JakubKostecki/Arduino-plant-watering-system/README.md

# Arduino-plant-watering-system

System made with collaboration with my Friend
