JakubKostecki/Arduino-plant-watering-system/Raport_Koncowy_JK_SK (1).pdf

# Raport końcowy

# Automatyczny System Podlewania Roślin

Wykonali:

Jakub Kostecki

Szymon Krzyworzeka

Prowadzący:

Dr. hab. inż. Barbara Swatowska

Dr. hab. inż. Andrzej Brudnik

## Spis treści:

## 1. Rozpoznanie rozwiązań w literaturze

## 2. Propozycje realizacji projektu brane pod uwagę

## 3. Realizacja Projektu

## 4. Testy/Uwagi

## 1. Rozpoznanie rozwiązań w literaturze

Cel projektu:

Celem projektu było zaprojektowanie i zbudowanie automatycznego systemu podlewającego rośliny doniczkowe na podstawie pomiaru wilgotności gleby. Urządzenie ma być małych rozmiarów, przenośne i nie wymagać podłączenia do sieci elektrycznej ani wodociągowej. W przypadku braku wody w zbiorniku do podlewania, system informuje o tym użytkownika.

Informowanie o konieczności podlania (2) (https://budmech.pl/czujniki-wilgotnosci-gleby-rozwiazanie-prawie-idealne/)

Pomiar wilgotności gleby.
Zastosowanie czujnika wilgotności gleby umożliwia stałą kontrolę nad poziomem nawodnienia gleby. Pozwala to uniknąć sytuacji gdzie częstotliwość nawadniania nie jest wystarczająca w zaistniałych warunkach zewnętrznych. Minusem takiego rozwiązania jest konieczność założenia, że gleba powinna być stale wilgotna.

Sposób nawadniania rośliny (3) (https://www.nawodnienia.eu/aktualnosci/system-nawadniania-zrob-to-sam-01-jak-zmierzyc-zrodlo-wody,p244767956)

Pobieranie wody ze zbiornika.
Główna zaletą takiego rozwiązania jest możliwość instalacji urządzenia bez konieczności podłączania się do systemu wodnego, dzięki czemu urządzenie nabiera charakteru przenośnego. Powstaje natomiast problem wyczerpywania się wody w zbiorniku. Implementacja systemu powiadamiającego o niskim poziomie wody zapobiega sytuacji w której roślina nie może zostać podlana. Woda ze zbiornika jest pobierana z niego za pomocą pompy zanurzeniowej, bądź pompy wodnej.

Obsługa systemu

Najprostszym rozwiązaniem jest zastosowanie mikrokontrolera, który kontroluje pracę systemu nawadniającego.

Kontrola Poziomu wody w zbiorniku (4)( (https://holmes.iigw.pl/~wbanach/dydaktyka/hydrologia_inf/pliki/laboratorium/pomiar_stanu_wody.pdf)5)( (https://automatykab2b.pl/technika/38496-pomiary-poziomu-cieczy-i-materialow-sypkich)6) (https://www.youtube.com/watch?v=RoqwsGKcHNU&ab_channel=MuzeumElektroniki-%C5%81ukaszBazarnik)

Zastosowanie rezystancyjnego czujnika poziomu wody.
Zaletą takiego rozwiązania jest możliwość bezpośredniej kontroli wody w zbiorniku (pomiar jest pobierany bezpośrednio ze zbiornika a nie wyliczany na podstawie przewidywanego stanu układu po danym czasie pracy). Nie jest jednak idealne, gdyż czujnik wilgotności może być podatny na parowanie wody, która osadzając się na czujniku może przekłamywać pomiar

Zasilanie układu (7) (https://intertechacademy.pl/2021/01/zasilanie-elektroniki-z-baterii-i-akumulatorow/)

Baterie
Zaletą takiego rozwiązania jest brak konieczności dostępu do sieci elektrycznej. Jednak baterie alkaliczne są trudne w utylizacji i należy je stale wymieniać.

Sposoby powiadamiania o niskim poziomie wody w zbiorniku

Za pomocą dźwięku
Zainstalowanie małego głośnika w systemie pozwala na odtwarzanie dźwięku. Takie rozwiązanie pozwala skutecznie powiadomić użytkownika o konieczności uzupełnienia zbiornika z wodą.

Zdalne monitorowanie pojemności zbiornika wody
Za pomocą mikrokontrolera oraz modułu WI-FI wykonano stronę internetową, która w czasie rzeczywistym informuje użytkownika o stanie wody w zbiorniku

## 2. Propozycje realizacji projektu brane pod uwagę

Elementy potrzebne do realizacji projektu

- Mikrokontroler (obsługa sensorów)
- Czujnik wilgotności gleby
- Czujnik poziomu wody w zbiorniku
- Zasilanie (bateria)
- Przekaźnik
- Pompa do cieczy
- Urządzenie powiadamiające o niskim poziomie wody za pomocą dźwięku

### 1. Moduł z mikrokontrolerem

- Moduł WiFi ESP8266 + NodeMCU v3

To urządzenie sprosta naszym wymaganiom, może być programowanie z użyciem języka Arduino i jest w dobrej cenie. Dodatkowo ma wbudowany moduł Wi-Fi który jest konieczny do stworzenia strony internetowej wyświetlającej stan wody w zbiorniku.

### 2. Czujnik wilgotności gleby

- MOD-01588

To urządzenie jest w przystępnej cenie i posiada wyjście cyfrowe. Jest kompatybilne z Arduino.

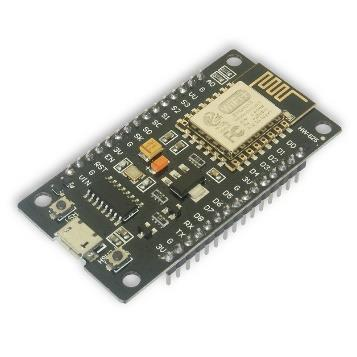
[picture p1: figure]

Zdjęcie 1 - Moduł ESP8266
Źródło : botland (https://botland.com.pl/moduly-wifi-esp8266/8241-modul-wifi-esp8266-nodemcu-v3-5904422300630.html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)

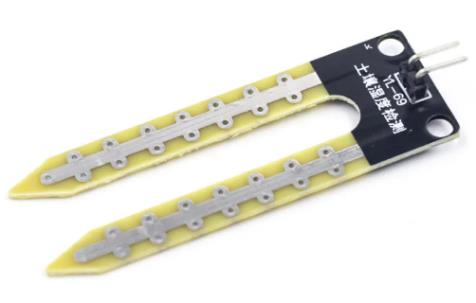
[picture p2: figure]

Zdjęcie 2 - Czujnik wilgotności gleby Źródło : modulosy (https://modulosy.pl/czujniki-wilgotnosci/282-czujnik-sensor-wilgotnosci-gleby-sensor-hygrometr-do-arduino-5903689131353.html)

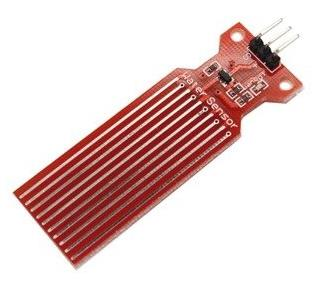
[picture p3: figure]

### 3. Czujnik poziomu wody

- Iduino SE045

Czujnik służący do wyznaczania poziomu cieczy w naczyniu. Zasilany jest napięciem 5,0 V. Wyjściem jest napięcie analogowe, które zwiększa swoją wartość wraz głębokością zanurzenia sondy.

### 4. Zasilanie

- Baterie alkaliczne

Baterie alkaliczne pozwalają na zminimalizowanie wymiarów urządzenia, ponadto są stosunkowo tanie.

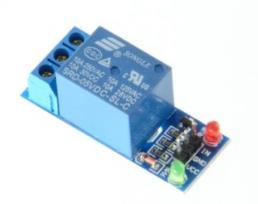
[picture p4: figure]

### 5. Przekaźnik do sterowania pompą wodną

- Przekaźnik

Moduł wyposażony w przekaźnik JQC-3FF-S-Z z cewką zasilaną napięciem 5 V bez optycznej izolacji wejścia. Układ pozwala na sterowanie elementami wykonawczymi przy pomocy portów mikrokontrolera lub dowolnego zestawu uruchomieniowego. Pracuje z napięciem do 250 V. Jest to element umożliwiający galwaniczne odseparowanie modułu pompy od reszty układu

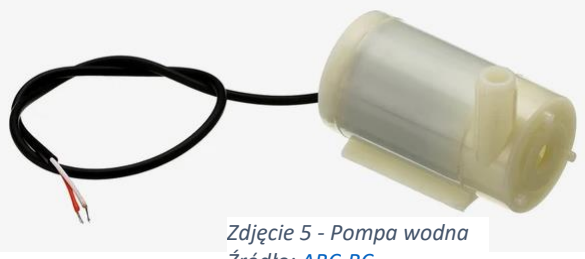
[picture p5: figure]
Zdjęcie 5 - Pompa wodna

### 6. Pompa do cieczy

- Pompa wodna 6V GRL-14164

Ta pompa jest zasilana niskim napięciem i nie ma dużego przepływu wody co pomoże uniknąć problemów związanych z ewentualnym rozlaniem

### 7. Urządzenie powiadamiające o niskim poziomie wody

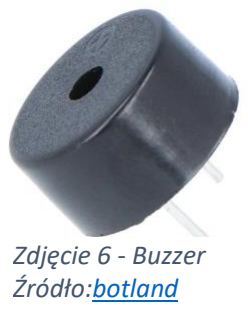
[picture p6: figure]
Zdjęcie 6 - Buzzer Źródło:botland

- Buzzer

Buzzer bez generatora o średnicy 14 mm. Zasilany napięciem z zakresu od 3 V do 16 V zdolny do wytwarzania dźwięku do 80 dB

Zdjęcie 3 - Czujnik poziomu wody Źródło : ABC-RC (https://abc-rc.pl/product-pol-6320-Czujnik-poziomu-wody-Water-Sensor-do-Arduino.html)

Zdjęcie 4 - Przekaźnik
Źródło: kostrzewniki (https://kostrzewinki.pl/modul-przekaznika-systemie-domoticz/)

Źródło: ABC-RC (https://abc-rc.pl/product-pol-9181-Mini-Pompa-do-wody-DC-3V-6V-1W-100l-h-pompka-cieczy.html)

Potencjalne problemy przy realizacji projektu na które trzeba zwrócić uwagę

1. Mały rozmiar układu i jego podręczność
2. Szczelność uszczelek przy pompie wodnej
3. Rozsądny i świadomy wybór komponentów pozwalający na zminimalizowanie rozmiaru oraz wagi układu.
4. Dodatkowe zabezpieczenie połączeń węży hydraulicznych

Pozostałe elementy niezbędne do wykonania projektu

- Przekaźnik
- Buzzer
- Przewody
- Rurki PCV
- Naczynie na wodę
- Doniczka z rośliną

Wycena komponentów na dzień 15.10.2022

Komponent | Cena zł
Mikrokontroler (obsługa sensorów) | 26,10
Czujnik wilgotności gleby | 5,50
Czujnik poziomu wody w zbiorniku | 3,90
Zasilanie (bateria) | 11,20
Przekaźnik | 7,90
Pompa do cieczy | 24.90
Buzzer | 2,20
Diody LED | 4,90
Przewody | 5,10
Rurki PCV | 9,00
Roślina doniczkowa | 15,00
Naczynie na wodę | 10,00
Dostawa | 9,90
SUMA | 135,60

## 3. Realizacja projektu

Część sprzętowa

Prototyp układu został zmontowany przy użyciu przewodów połączeniowych według schematu na rysunku X Układ jest zasilany za pomocą przenośnej ładowarki oraz baterii 9V przy czym bateria jest odpowiedzialna wyłącznie za zasilanie pompy. Zastosowany w prototypie czujnik wilgotności gleby daje na wyjściu sygnał cyfrowy gdzie stan wysoki wyjścia czujnika odpowiada niskiej wilgotności gleby. Do sygnalizacji konieczności uzupełnienia wody w zbiorniku wykorzystano buzzer aktywowany stanem wysokim w momencie, gdy odczyt czujnika wilgotności wskaże, że w zbiorniku jest pusto.

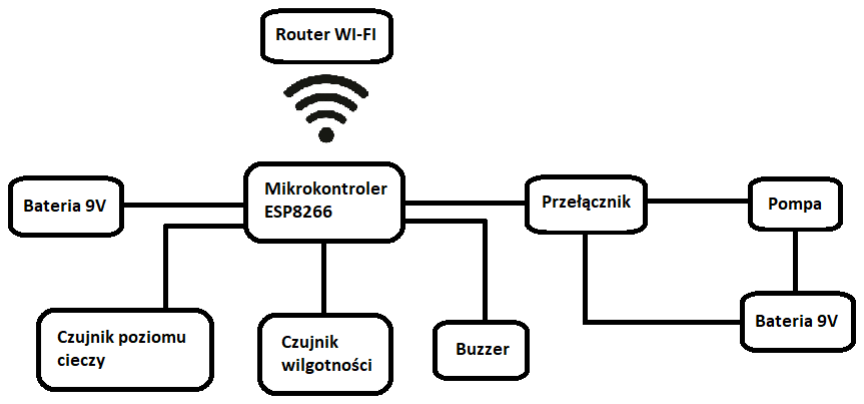
[picture p7: figure]

Rysunek 1- Schemat montażowy prototypu układu

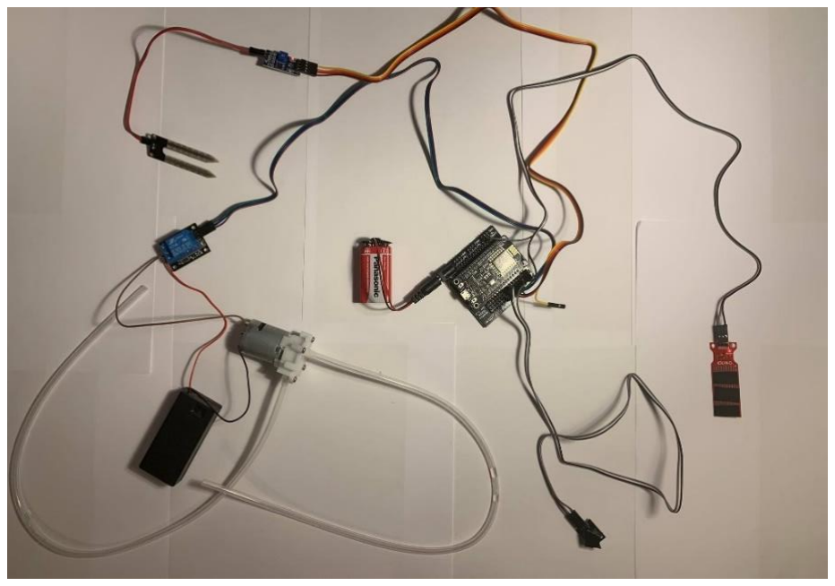
[picture p8: figure]

Zdjęcie 7 - Prototyp układu

Część programowa

Czujnik poziomu cieczy daje na wyjściu sygnał analogowy o natężeniu proporcjonalnym do zanurzenia sensora w wodzie. Na podstawie jego wskazania można ustalić 4 poziomy wody przyjazne do odczytu dające ogólne pojęcie o stanie zbiornika.

a. Odczyt czujnika < 200 – pusto
b. 200 < Odczyt czujnika < 400 – stan niski
c. 400 < Odczyt czujnika < 450 – stan średni
d. 450 < Odczyt czujnika – stan wysoki

Takie informacje są możliwe do odczytania korzystając z urządzeń połączonych do sieci WI-FI jeśli układ jest z nią powiązany.

Aby uniknąć aktywacji pompy w momencie, gdy w zbiorniku nie ma wody zaprogramowano kontroler w taki sposób, aby umożliwiał aktywację pompy wyłącznie, gdy wskazanie czujnika poziomu cieczy jest wyższe niż 200. Zatem pompa jest uruchamiana za pomocą przełącznika gdy dwa warunki zostaną spełnione:

a. W zbiorniku znajduje się wystarczająco wody aby zapewnić bezpieczną i wydajną pracę pompy
b. Pojawienie się stanu niskiego na wyjściu czujnika wilgotności gleby

Aby korzystać z modułu WI-FI konieczne było skorzystanie z biblioteki ESP8266WiFi

Aby utworzyć serwer asynchroniczny i za jego pośrednictwem wyświetlać informacje o stanie wody w zbiorniku skorzystano z biblioteki ESPAsyncWebServer powstałej w oparciu o bibliotekę ESPAsyncTCP.

Strona internetowa została stworzona w HTML i dane z czujnika poziomu cieczy są do niej przesyłane w funkcji

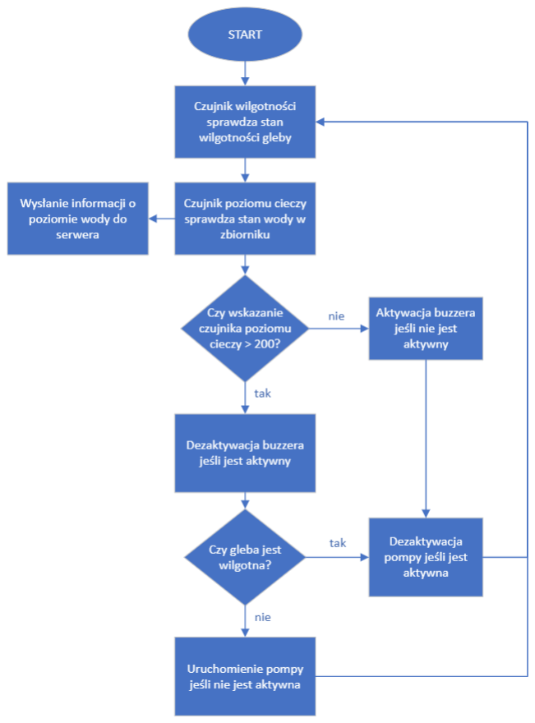
[picture p9: figure]

Rysunek 2- schemat blokowy kodu obsługującego system nawadniania

## 4. Testy i uwagi

Po zmontowaniu układu na płytce drukowanej (zdjęcie nr. 10), układ przeszedł do fazy testowania.

Wykonano testy działania systemu aby sprawdzić poprawność działania w następujących przypadkach:
a) W zbiorniku znajduje się woda i gleba jest wilgotna - urządzenie zgodnie z założeniami nie
uruchamia | | | | | | | pompy
b) W zbiorniku znajduje się woda i gleba jest sucha - urządzenie zgodnie z założeniami
uruchamia | | | | | | | pompę
c) Zbiornik na wodę jest pusty i gleba jest wilgotna - urządzenie uruchamia buzzer i sygnalizuje
konieczność | uzupełnienia | wody | w | zbiorniku, | pompa | pozostaje | nieaktywna
d) Zbiornik na wodę jest pusty i gleba jest sucha - urządzenie uruchamia buzzer i sygnalizuje konieczność uzupełnienia wody w zbiorniku, pompa pozostaje nieaktywna

Wykonano także testy informowania o poziomie wody w zbiorniku, zauważono iż czasami wskazanie czujnika poziomu może być przekłamane w sytuacji, gdy w krótkim czasie urządzenie wykorzystało znaczną część wody ze zbiornika. Powodem takiego zachowania układu jest fakt, że woda na czujniku poziomu osadza się i musi upłynąć trochę czasu aby niezanurzona część czujnika wyschła. Po upływie paru minut odczyt się stabilizuje i pozostaje zgodny ze stanem rzeczywistym.

Uruchomiono układ na okres 5 dni i aby sprawdzić wytrzymałość komponentów. Podczas okresu testowego przełącznik uruchamiający pompę przestał działać, konieczna była wymiana na nowy model, ponieważ poprzedni był wadliwy.

Dodatkowo zauważono, że czujniki wilgotności gleby i poziomu wody w zbiorniku szybko się zużywają i muszą być wymieniane. Ze względu na konieczność wymiany komponentów zdecydowano się na zastosowanie płytki drukowanej, co ułatwia proces wymiany, ponieważ użytkownik nie musi się martwić o odpowiednie podłączenie okablowania do mikrokontrolera.

Konieczność wymiany rurek odprowadzających ciecz z pompy wodnej. Początkowo użyto rurek z poliuretanu, takowy materiał nie nadaje się do zastosowania przy pompie o mocy 5V. Przy wymianie materiału z którego są wykonane rurki na silikon, woda przepływała przez pompę bez zarzutów.

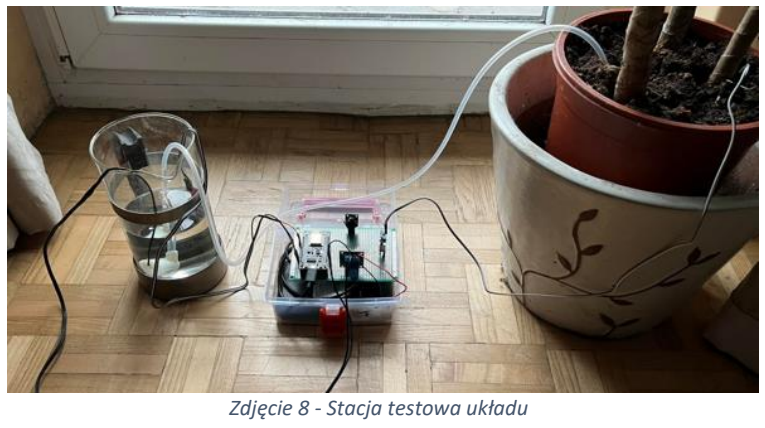
[picture p10: figure]
Zdjęcie 8 - Stacja testowa układu
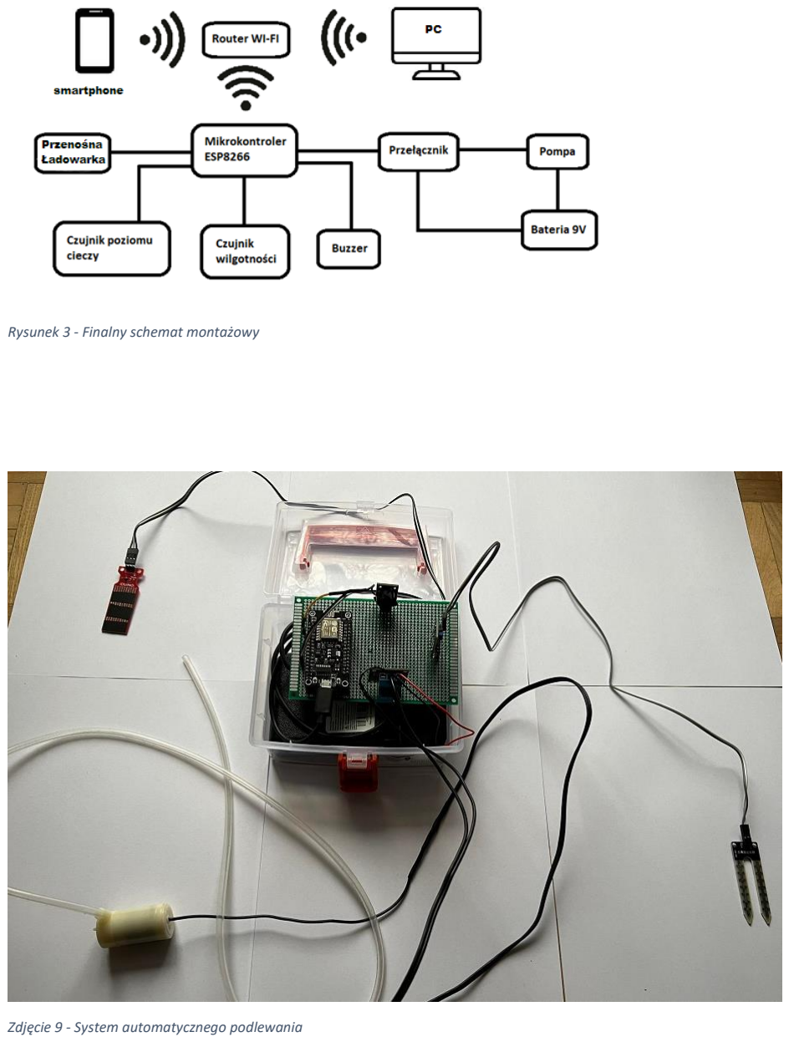
[picture p11: page 11]

Rysunek 3 - Finalny schemat montażowy

Zdjęcie 9 - System automatycznego podlewania

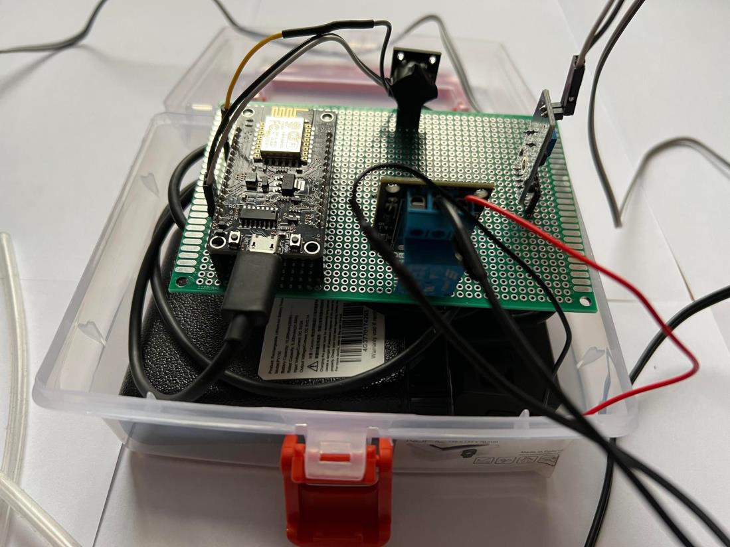
[picture p12: figure]

Zdjęcie 10 - System automatycznego podlewania

Literatura:

1. Uniwersytet Przyrodniczy we Wrocławiu - “Eksperci UPWr: Jak dbać o rośliny doniczkowe”, 16.04.2021 ( dostęp 29.10.2022)
2. Budmech - “Czujniki wilgotności gleby - rozwiązanie prawie idealne”, 30 lipca 2017( dostęp 29.10.2022)
3. Nawodnienia.eu- „System nawadniania – zrób to sam- 01 Jak zmierzyć źródło wody”, 31.08.2019 ( dostęp 29.10.2022)
4. W.Banach – “Pomiar stanu i głębokości wody” ( dostęp 29.10.2022)
5. Marek Strzelczyk – “Pomiary poziomu cieczy i materiałów sypkich” 18.02.2008 ( dostęp 29.10.2022)
6. Łukasz Bazarnik – “Prosty wskaźnik poziomu wody pod napięciem” 11.01.2019 ( dostęp 29.10.2022)
7. Maciej Kraszewski – “Zasilanie elektroniki z baterii i akumulatorów” 16.01.2021 ( dostęp 29.10.2022)
